pyroesp/Saturn-Racing-PC/(commit log)

2020-10-16 arduino pro micro ino file
2020-10-16 added kicad stuff to ignore
2020-10-16 added wiring schematic
    [Schematic.kicad_pcb, Schematic.sch]
